rhkean/ESP32-S3-Pico-D1/jlcpcb/orders/README.md

Create folders with the order number and date
then move the files from ./production_files into the new folder
