rhkean/ESP32-S3-Pico-D1/ESP32-S3 Pico D1.kicad_pcb

## KiCad design ESP32-S3 Pico D1.kicad_pcb (2026-02-12)

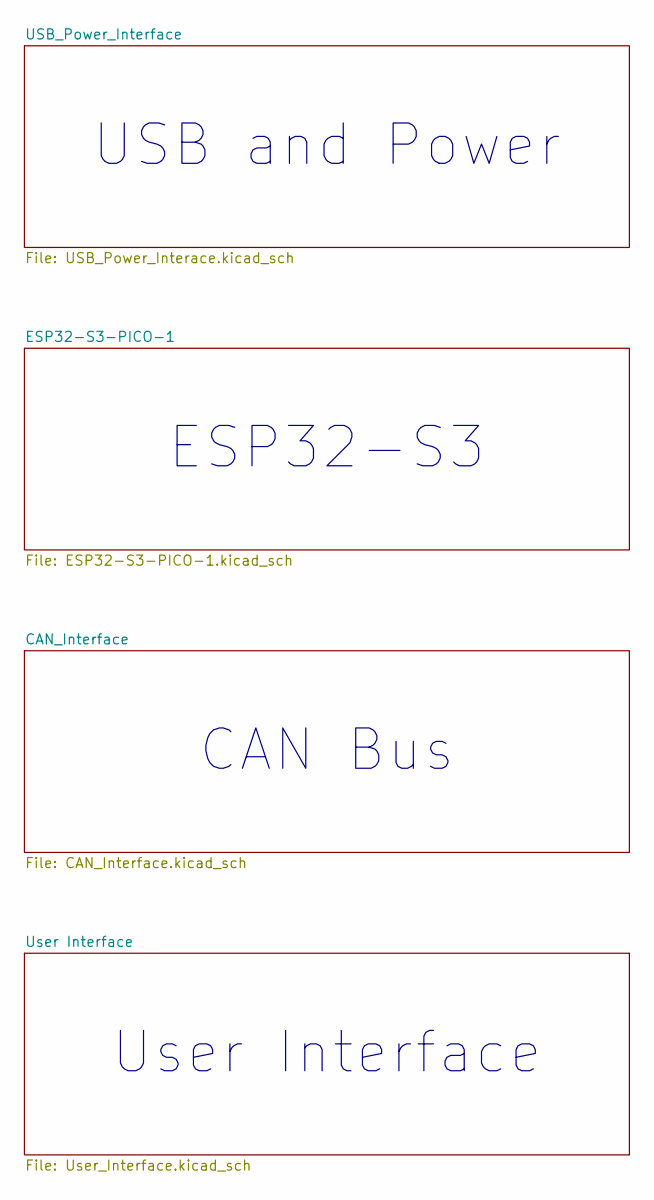
[picture p1: schematic ESP32-S3 Pico D1.kicad_sch, ESP32-S3 D1 Pico]

Notes on the sheet:
ESP32-S3
User Interface
USB and Power
CAN Bus

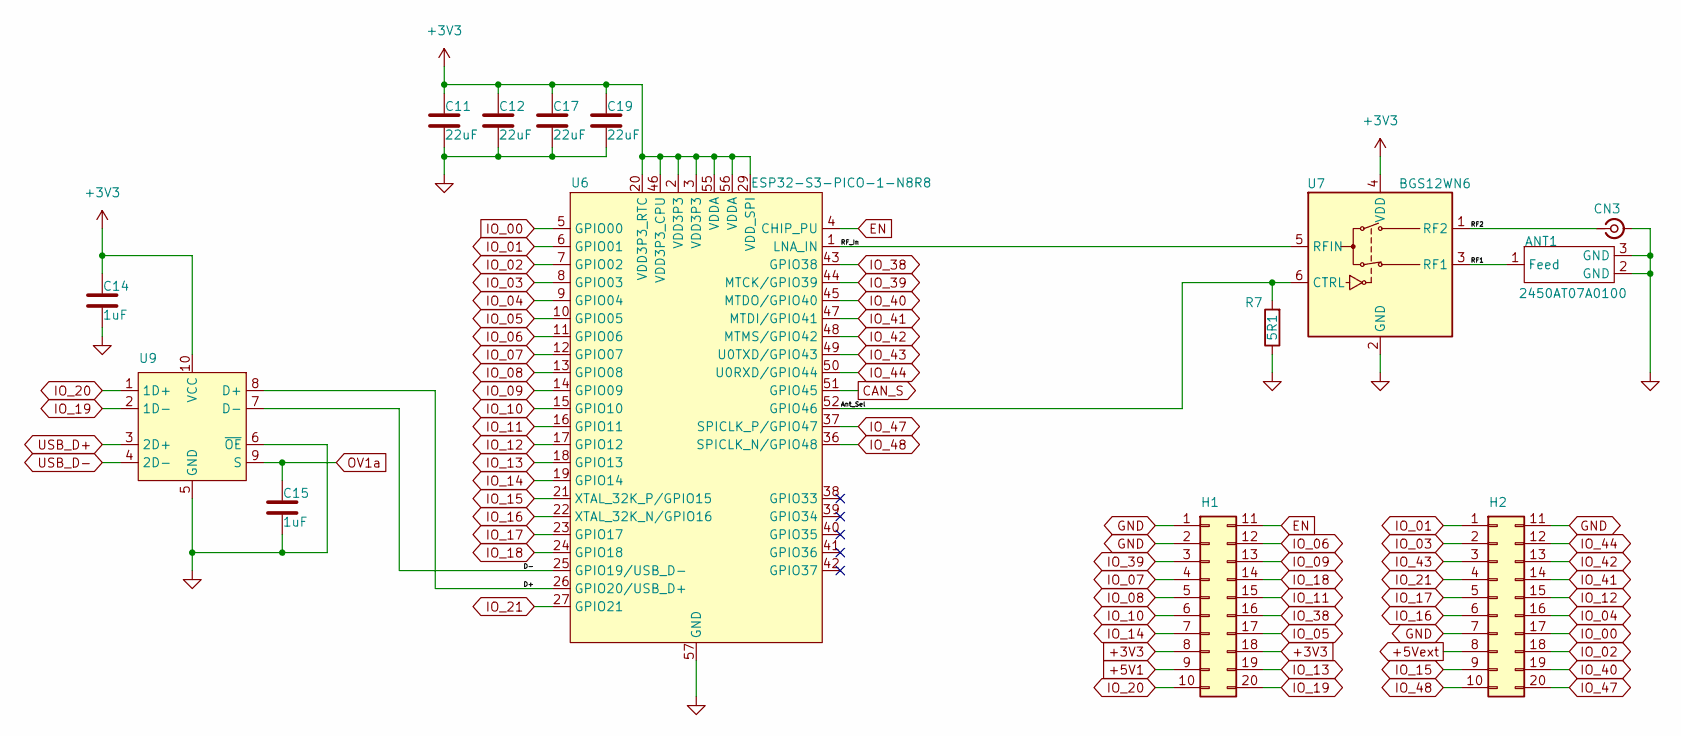
[picture p2: schematic ESP32-S3-PICO-1.kicad_sch]

Parts:
ANT1: 2450AT07A0100; Chip Antenna 0402; Manufacturer Part Number 2450AT07A0100; LCSC C17531353
C11, C12, C17, C19: 22uF; C0402_Dense; Manufacturer Part Number GRM158R61A226ME15D; LCSC C3845593
C14, C15: 1uF; C0201_Dense; Manufacturer Part Number CL03A105MO3NRNH; LCSC C307385
CN3: Conn_Coaxial_Small; U.FL_Molex_MCRF_73412; Manufacturer Part Number 734123150; LCSC C434806
H1, H2: ESP_Header; PinHeader_2x10_P2.54mm_Vertical
R7: 5R1; R0201_Dense; Manufacturer Part Number PF01WMF510KTEE; LCSC C50670526
U6: ESP32-S3-PICO-1-N8R8; ESP32-S3-Pico-1; Manufacturer Part Number ESP32-S3-PICO-1-N8R2; LCSC C7558093
U7: BGS12WN6; TSNP-6; Manufacturer Part Number BGS12WN6E6327XTSA1, BGS12WN6E6329XTSA1; LCSC C1854968, C27749420
U9: TS3USB221A-Q1; Texas_UQFN-10_1.5x2mm_P0.5mm; Manufacturer Part Number TS3USB221AQRSERQ1; LCSC C181564

Connections:
+3V3: C11.1, C12.1, C14.1, C17.1, C19.1, H1.8, H1.18, U6.2 (VDD3P3), U6.3 (VDD3P3), U6.20 (VDD3P3_RTC), U6.29 (VDD_SPI), U6.46 (VDD3P3_CPU), U6.55 (VDDA), U6.56 (VDDA), U7.4 (VDD), U9.10 (VCC); also elsewhere on the board
+5V1: H1.9; also elsewhere on the board
+5Vext: H2.8; also elsewhere on the board
/ESP32-S3-PICO-1/Ant_Sel: R7.2, U6.52 (GPIO46), U7.6 (CTRL)
/ESP32-S3-PICO-1/D+: U6.26 (GPIO20/USB_D+), U9.8 (D+)
/ESP32-S3-PICO-1/D-: U6.25 (GPIO19/USB_D-), U9.7 (D-)
/ESP32-S3-PICO-1/RF1: ANT1.1 (Feed), ANT1.4 (Feed), U7.3 (RF1)
/ESP32-S3-PICO-1/RF2: CN3.1 (In), U7.1 (RF2)
/ESP32-S3-PICO-1/RF_In: U6.1 (LNA_IN), U7.5 (RFIN)
CAN_S: U6.51 (GPIO45); also elsewhere on the board
EN: H1.11, U6.4 (CHIP_PU); also elsewhere on the board
GND: ANT1.2 (GND), ANT1.3 (GND), C11.2, C12.2, C14.2, C15.2, C17.2, C19.2, CN3.2 (Ext), H1.1, H1.2, H2.7, H2.11, R7.1, U6.57 (GND), U7.2 (GND), U9.5 (GND), U9.6 (~OE); also elsewhere on the board
IO_00: H2.17, U6.5 (GPIO00); also elsewhere on the board
IO_01: H2.1, U6.6 (GPIO01)
IO_02: H2.18, U6.7 (GPIO02); also elsewhere on the board
IO_03: H2.2, U6.8 (GPIO03)
IO_04: H2.16, U6.9 (GPIO04)
IO_05: H1.17, U6.10 (GPIO05)
IO_06: H1.12, U6.11 (GPIO06)
IO_07: H1.4, U6.12 (GPIO07)
IO_08: H1.5, U6.13 (GPIO08)
IO_09: H1.13, U6.14 (GPIO09)
IO_10: H1.6, U6.15 (GPIO10)
IO_11: H1.15, U6.16 (GPIO11)
IO_12: H2.15, U6.17 (GPIO12)
IO_13: H1.19, U6.18 (GPIO13)
IO_14: H1.7, U6.19 (GPIO14)
IO_15: H2.9, U6.21 (XTAL_32K_P/GPIO15)
IO_16: H2.6, U6.22 (XTAL_32K_N/GPIO16)
IO_17: H2.5, U6.23 (GPIO17)
IO_18: H1.14, U6.24 (GPIO18)
IO_19: H1.20, U9.2 (1D-)
IO_20: H1.10, U9.1 (1D+)
IO_21: H2.4, U6.27 (GPIO21)
IO_38: H1.16, U6.43 (GPIO38)
IO_39: H1.3, U6.44 (MTCK/GPIO39)
IO_40: H2.19, U6.45 (MTDO/GPIO40)
IO_41: H2.14, U6.47 (MTDI/GPIO41)
IO_42: H2.13, U6.48 (MTMS/GPIO42)
IO_43: H2.3, U6.49 (U0TXD/GPIO43)
IO_44: H2.12, U6.50 (U0RXD/GPIO44)
IO_47: H2.20, U6.37 (SPICLK_P/GPIO47); also elsewhere on the board
IO_48: H2.10, U6.36 (SPICLK_N/GPIO48); also elsewhere on the board
OV1a: C15.1, U9.9 (S); also elsewhere on the board
USB_D+: U9.3 (2D+); also elsewhere on the board
USB_D-: U9.4 (2D-); also elsewhere on the board

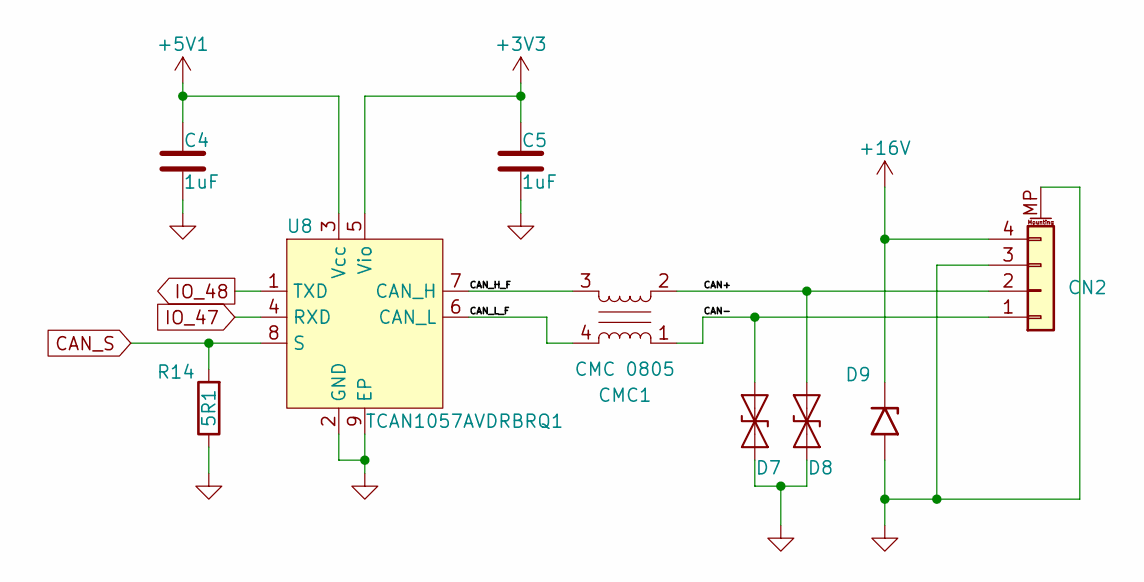
[picture p3: schematic CAN_Interface.kicad_sch]

Parts:
C4, C5: 1uF; C0201_Dense; Manufacturer Part Number CL03A105MO3NRNH; LCSC C307385
CMC1: CMC 0805; CMC_0805; Manufacturer Part Number ACM2012H-900-2P-T03; LCSC C448605
CN2: BM04B-ACHSS; JST_ACH_BM04B-ACHSS-A-GAN-ETF_1x04-1MP_P1.20mm_Vertical; Manufacturer Part Number BM04B-ACHSS-A-GAN-TF(LF)(SN), BM04B-ACH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; LCSC C46772640, C5246838, C5308725
D7, D8: PESD24VF1BL-Q; DFN1006-2; Manufacturer Part Number PESD24VF1BBL-Q; LCSC C22465859
D9: VESD16C1-HD1HG3-08; DFN1006-2; Manufacturer Part Number VESD16C1-HD1HG3-08; LCSC C3703781
R14: 5R1; R0201_Dense; Manufacturer Part Number PF01WMF510KTEE; LCSC C50670526
U8: TCAN1057AVDRBRQ1; VSON-8-1EP_3x3mm_P0.65mm_EP1.65x2.4mm_ThermalVias; Manufacturer Part Number TCAN1057AVDRBRQ1; LCSC C3234121

Connections:
+3V3: C5.1, U8.5 (Vio); also elsewhere on the board
+5V1: C4.1, U8.3 (Vcc); also elsewhere on the board
+16V: CN2.4 (CAN_H), D9.1 (A1); also elsewhere on the board
/CAN_Interface/CAN+: CMC1.2, CN2.2 (+12V), D8.1 (A1)
/CAN_Interface/CAN-: CMC1.1, CN2.1 (GND), D7.1 (A1)
/CAN_Interface/CAN_H_F: CMC1.3, U8.7 (CAN_H)
/CAN_Interface/CAN_L_F: CMC1.4, U8.6 (CAN_L)
CAN_S: R14.2, U8.8 (S); also elsewhere on the board
GND: C4.2, C5.2, CN2.3 (CAN_L), CN2.MP (MountPin), D7.2 (A2), D8.2 (A2), D9.2 (A2), R14.1, U8.2 (GND), U8.9 (EP); also elsewhere on the board
IO_47: U8.4 (RXD); also elsewhere on the board
IO_48: U8.1 (TXD); also elsewhere on the board

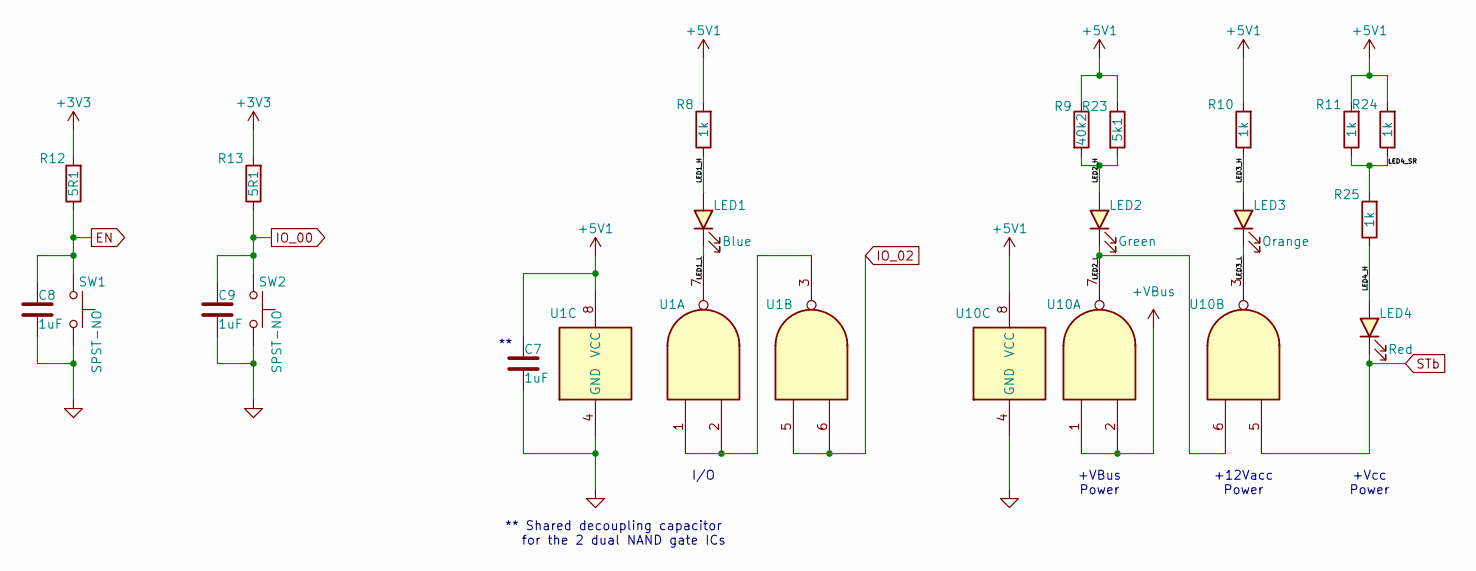
[picture p4: schematic User_Interface.kicad_sch]

Parts:
C7, C8, C9: 1uF; C0201_Dense; Manufacturer Part Number CL03A105MO3NRNH; LCSC C307385
LED1: Blue; LED_0201-2; Manufacturer Part Number XL-0201UBC; LCSC C3646921
LED2: Green; LED_0201-2; Manufacturer Part Number XL-0201UGC; LCSC C3646922
LED3: Orange; LED_0201-2; Manufacturer Part Number XL-0201UOC; LCSC C5440629
LED4: Red; LED_0201-2; Manufacturer Part Number XL-0201SURC; LCSC C3646923
R8, R10, R11, R24, R25: 1k; R0201_Dense; Manufacturer Part Number PF01WMF510KTEE; LCSC C50670526
R9: 40k2; R0201_Dense; Manufacturer Part Number AC0201FR-0726K1L; LCSC C910625
R12, R13: 5R1; R0201_Dense; Manufacturer Part Number PF01WMF510KTEE; LCSC C50670526
R23: 5k1; R0201_Dense; Manufacturer Part Number AC0201FR-0726K1L; LCSC C910625
SW1, SW2: SPST-NO; SW_SPST_B3U_series; Manufacturer Part Number B3U-3000P(M)-B; LCSC C4364471
U1, U10: NC7WZ132L8X; UQFN8_1.6x1.6mm_P0.5; Manufacturer Part Number NC7WZ132L8X; LCSC C895626

Connections:
+3V3: R12.2, R13.2; also elsewhere on the board
+5V1: C7.1, R8.2, R9.1, R10.2, R11.2, R23.1, R24.2, U1.8 (VCC), U10.8 (VCC); also elsewhere on the board
+VBus: U10.1, U10.2; also elsewhere on the board
/User Interface/LED1_H: LED1.2 (A), R8.1
/User Interface/LED1_L: LED1.1 (K), U1.7
/User Interface/LED2_H: LED2.2 (A), R9.2, R23.2
/User Interface/LED2_L: LED2.1 (K), U10.6, U10.7
/User Interface/LED3_H: LED3.2 (A), R10.1
/User Interface/LED3_L: LED3.1 (K), U10.3
/User Interface/LED4_H: LED4.2 (A), R25.1
/User Interface/LED4_SR: R11.1, R24.1, R25.2
EN: C8.1, R12.1, SW1.1; also elsewhere on the board
GND: C7.2, C8.2, C9.2, SW1.2, SW2.2, U1.4 (GND), U10.4 (GND); also elsewhere on the board
IO_00: C9.1, R13.1, SW2.1; also elsewhere on the board
IO_02: U1.5, U1.6; also elsewhere on the board
unnamed: U1.1, U1.2, U1.3
STb: LED4.1 (K), U10.5; also elsewhere on the board

Notes on the sheet:
** Shared decoupling capacitor for the 2 dual NAND gate ICs
+Vcc Power
+12Vacc Power
I/O
+VBus Power

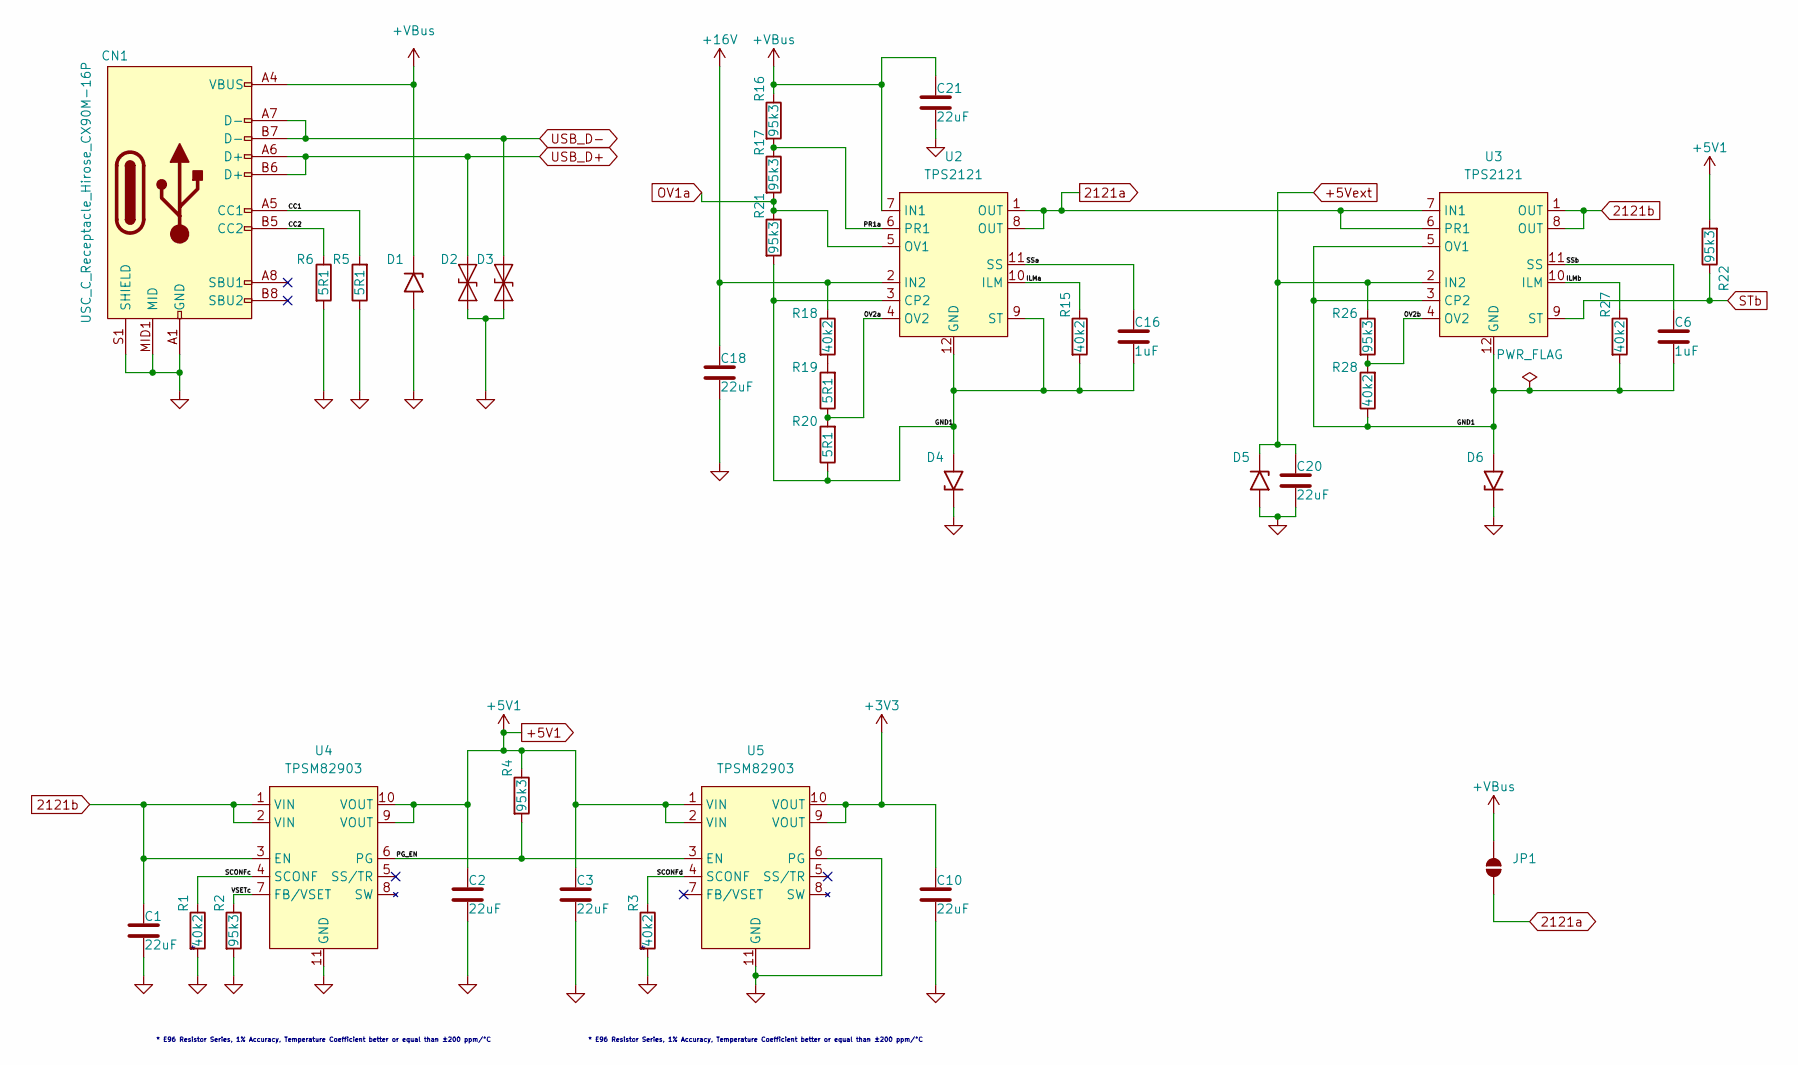
[picture p5: schematic USB_Power_Interace.kicad_sch]

Parts:
C1, C18: 22uF; C0603_Dense; Manufacturer Part Number GRM188C61E226ME01D; LCSC C29519229
C2, C3, C10: 22uF; C0402_Nominal; Manufacturer Part Number GRM158R61A226ME15D; LCSC C3845593
C6, C16: 1uF; C0201_Dense; Manufacturer Part Number CL03A105MO3NRNH; LCSC C307385
C20, C21: 22uF; C0402_Dense; Manufacturer Part Number GRM158R61A226ME15D; LCSC C3845593
CN1: USC_C_Receptacle_Hirose_CX90M-16P; USB_C_Receptacle_Hirose_CX90M-16P; Manufacturer Part Number CX90M-16P; LCSC C2889324
D1, D4, D5, D6: VESD16C1-HD1HG3-08; DFN1006-2; Manufacturer Part Number VESD16C1-HD1HG3-08; LCSC C3703781
D2, D3: PESD24VF1BL-Q; DFN1006-2; Manufacturer Part Number PESD24VF1BBL-Q; LCSC C22465859
JP1: SolderJumper_2_Open; SolderJumper-2_Open
R1, R3: 40k2; R0201_Dense; Manufacturer Part Number AC0201FR-0726K1L; LCSC C910625
R2, R4, R16, R17, R21, R22, R26: 95k3; R0201_Dense; Manufacturer Part Number 0201WMF9532TEE; LCSC C423395
R5, R6, R19, R20: 5R1; R0201_Dense; Manufacturer Part Number PF01WMF510KTEE; LCSC C50670526
R15, R18, R27: 40k2; R0201_Dense; Manufacturer Part Number 0201WMF9532TEE; LCSC C423395
R28: 40k2; R0201_Dense; Manufacturer Part Number PF01WMF510KTEE; LCSC C50670526
U2, U3: TPS2121; VQHN-HR-12; Manufacturer Part Number TPS2121RUXR; LCSC C485916
U4, U5: TPSM82903; uSIP-11_3.0x2.8_ThermalVias; Manufacturer Part Number TPSM82903SISR; LCSC C6290583

Connections:
2121a: JP1.1 (A), U2.1 (OUT), U2.8 (OUT), U3.6 (PR1), U3.7 (IN1)
2121b: C1.1, U3.1 (OUT), U3.8 (OUT), U4.1 (VIN), U4.2 (VIN), U4.3 (EN)
+3V3: C10.1, U5.9 (VOUT), U5.10 (VOUT); also elsewhere on the board
+5V1: C2.1, C3.1, R4.1, R22.2, U4.9 (VOUT), U4.10 (VOUT), U5.1 (VIN), U5.2 (VIN); also elsewhere on the board
+5Vext: C20.1, D5.1 (A1), R26.1, U3.2 (IN2); also elsewhere on the board
+16V: C18.1, R18.1, U2.2 (IN2); also elsewhere on the board
+VBus: C21.1, CN1.A4 (VBUS), CN1.A9 (VBUS), CN1.B4 (VBUS), CN1.B9 (VBUS), D1.1 (A1), JP1.2 (B), R16.1, U2.7 (IN1); also elsewhere on the board
/USB_Power_Interface/CC1: CN1.A5 (CC1), R5.2
/USB_Power_Interface/CC2: CN1.B5 (CC2), R6.1
/USB_Power_Interface/GND1: C6.2, C16.2, D4.2 (A2), D6.2 (A2), R15.2, R20.1, R21.2, R27.2, R28.1, U2.3 (CP2), U2.9 (ST), U2.12 (GND), U3.3 (CP2), U3.5 (OV1), U3.12 (GND)
/USB_Power_Interface/ILMa: R15.1, U2.10 (ILM)
/USB_Power_Interface/ILMb: R27.1, U3.10 (ILM)
/USB_Power_Interface/OV2a: R19.1, R20.2, U2.4 (OV2)
/USB_Power_Interface/OV2b: R26.2, R28.2, U3.4 (OV2)
/USB_Power_Interface/PG_EN: R4.2, U4.6 (PG), U5.3 (EN)
/USB_Power_Interface/PR1a: R16.2, R17.1, U2.6 (PR1)
/USB_Power_Interface/SCONFc: R1.1, U4.4 (SCONF)
/USB_Power_Interface/SCONFd: R3.1, U5.4 (SCONF)
/USB_Power_Interface/SSa: C16.1, U2.11 (SS)
/USB_Power_Interface/SSb: C6.1, U3.11 (SS)
/USB_Power_Interface/VSETc: R2.1, U4.7 (FB/VSET)
GND: C1.2, C2.2, C3.2, C10.2, C18.2, C20.2, C21.2, CN1.A1 (GND), CN1.A12 (GND), CN1.B1 (GND), CN1.B12 (GND), CN1.MID1 (MID), CN1.MID2 (MID), CN1.S1 (SHIELD), CN1.S2 (SHIELD), CN1.S3 (SHIELD), CN1.S4 (SHIELD), D1.2 (A2), D2.1 (A1), D3.1 (A1), D4.1 (A1), D5.2 (A2), D6.1 (A1), R1.2, R2.2, R3.2, R5.1, R6.2, U4.11 (GND), U5.6 (PG), U5.11 (GND); also elsewhere on the board
unnamed: R18.2, R19.2
OV1a: R17.2, R21.1, U2.5 (OV1); also elsewhere on the board
STb: R22.1, U3.9 (ST); also elsewhere on the board
USB_D+: CN1.A6 (D+), CN1.B6 (D+), D2.2 (A2); also elsewhere on the board
USB_D-: CN1.A7 (D-), CN1.B7 (D-), D3.2 (A2); also elsewhere on the board

Notes on the sheet:
* E96 Resistor Series, 1% Accuracy, Temperature Coefficient better or equal than ±200 ppm/°C

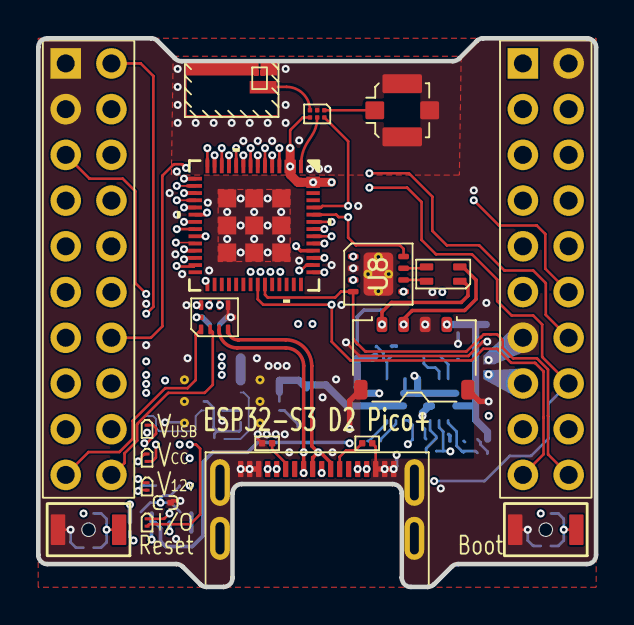
[picture p6: board ESP32-S3 Pico D1.kicad_pcb from above]

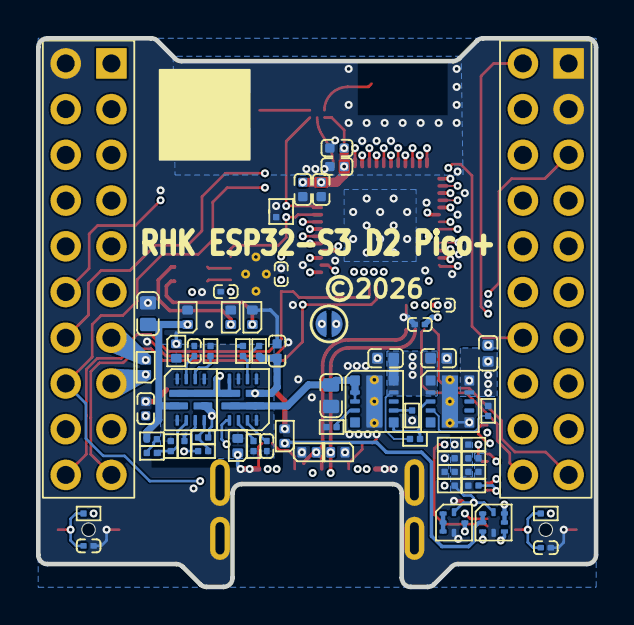
[picture p7: board ESP32-S3 Pico D1.kicad_pcb from below]

Board: 6 copper layers, 31.0 x 30.5 mm, 81 parts (61 on the bottom side), 79 nets.
