rhkean/ESP32-S3-Pico-D1/(notices)

Notices in the files:
ESP32-S3 Pico D1.kicad_pcb:
©2026
